NetCube-Systems-Austria/STM32-Ethernet-Board/STMNetBoard.sch

## KiCad design STMNetBoard.sch (2020-12-31)

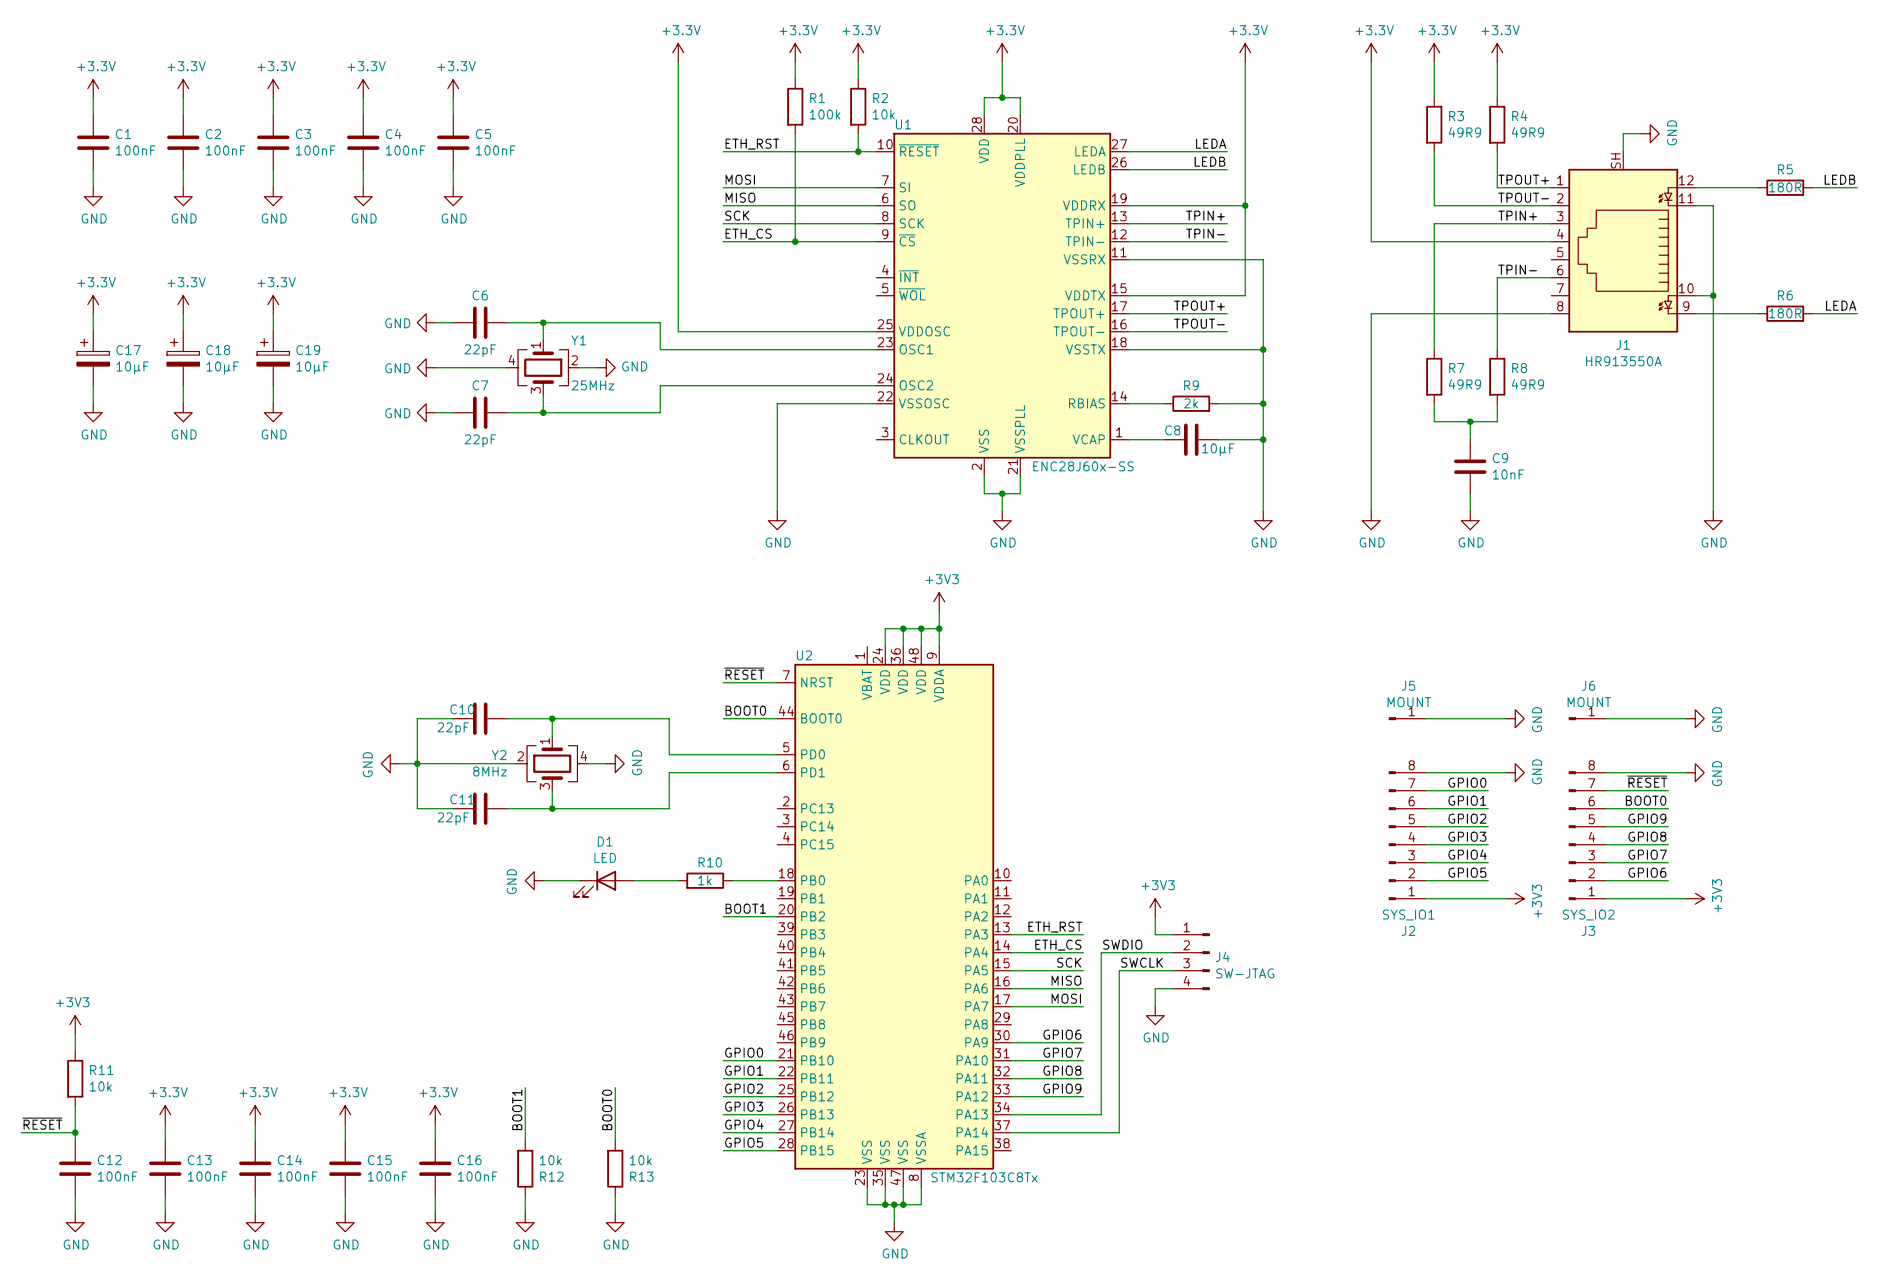
[picture p1: schematic STMNetBoard.sch]

Parts:
C1, C2, C3, C4, C5, C12, C13, C14, C15, C16: 100nF; C_0603_1608Metric; LCSC C14663
C6, C7, C10, C11: 22pF; C_0603_1608Metric; LCSC C1653
C8: 10µF; C_0603_1608Metric; LCSC C19702
C9: 10nF; C_0603_1608Metric; LCSC C57112
C17, C18, C19: 10µF; CP_EIA-3216-18_Kemet-A; LCSC C128254
D1: LED; LED_0603_1608Metric; LCSC C72038
J1: HR913550A; RJ45_Hanrun_HR911105A
J2: SYS_IO1; PinHeader_1x08_P2.54mm_Vertical
J3: SYS_IO2; PinHeader_1x08_P2.54mm_Vertical
J4: SW-JTAG; PinHeader_1x04_P2.54mm_Vertical
J5, J6: MOUNT; PinHeader_1x01_P2.54mm_Vertical
R1: 100k; R_0603_1608Metric; LCSC C25803
R2, R11, R12, R13: 10k; R_0603_1608Metric; LCSC C25804
R3, R4, R7, R8: 49R9; R_0603_1608Metric; LCSC C23185
R5, R6: 180R; R_0603_1608Metric; LCSC C22828
R9: 2k; R_0603_1608Metric; LCSC C22975
R10: 1k; R_0603_1608Metric; LCSC C21190
U1: ENC28J60x-SS; SSOP-28_5.3x10.2mm_P0.65mm; LCSC C8961
U2: STM32F103C8Tx; LQFP-48_7x7mm_P0.5mm; LCSC C8734
Y1: 25MHz; Crystal_SMD_3225-4Pin_3.2x2.5mm; LCSC C164045
Y2: 8MHz; Crystal_SMD_3225-4Pin_3.2x2.5mm; LCSC C117890

Connections:
+3.3V: C1.1, C2.1, C3.1, C4.1, C5.1, C13.1, C14.1, C15.1, C16.1, C17.1, C18.1, C19.1, J1.4, R1.1, R2.1, R3.1, R4.1, U1.15 (VDDTX), U1.19 (VDDRX), U1.20 (VDDPLL), U1.25 (VDDOSC), U1.28 (VDD)
+3V3: J2.1, J3.1, J4.1, R11.1, U2.9 (VDDA), U2.24 (VDD), U2.36 (VDD), U2.48 (VDD)
BOOT0: J3.6, R13.2, U2.44 (BOOT0)
BOOT1: R12.2, U2.20 (PB2)
ETH_CS: R1.2, U1.9 (~CS), U2.14 (PA4)
ETH_RST: R2.2, U1.10 (~RESET), U2.13 (PA3)
GND: C1.2, C2.2, C3.2, C4.2, C5.2, C6.2, C7.2, C8.1, C9.2, C10.2, C11.2, C12.2, C13.2, C14.2, C15.2, C16.2, C17.2, C18.2, C19.2, D1.1 (K), J1.8, J1.10, J1.11, J1.SH, J2.8, J3.8, J4.4, J5.1, J6.1, R9.2, R12.1, R13.1, U1.2 (VSS), U1.11 (VSSRX), U1.18 (VSSTX), U1.21 (VSSPLL), U1.22 (VSSOSC), U2.8 (VSSA), U2.23 (VSS), U2.35 (VSS), U2.47 (VSS), Y1.2, Y1.4, Y2.2, Y2.4
GPIO0: J2.7, U2.21 (PB10)
GPIO1: J2.6, U2.22 (PB11)
GPIO2: J2.5, U2.25 (PB12)
GPIO3: J2.4, U2.26 (PB13)
GPIO4: J2.3, U2.27 (PB14)
GPIO5: J2.2, U2.28 (PB15)
GPIO6: J3.2, U2.30 (PA9)
GPIO7: J3.3, U2.31 (PA10)
GPIO8: J3.4, U2.32 (PA11)
GPIO9: J3.5, U2.33 (PA12)
LEDA: R6.2, U1.27 (LEDA)
LEDB: R5.2, U1.26 (LEDB)
MISO: U1.6 (SO), U2.16 (PA6)
MOSI: U1.7 (SI), U2.17 (PA7)
unnamed: C6.1, U1.23 (OSC1), Y1.1
unnamed: C7.1, U1.24 (OSC2), Y1.3
unnamed: C8.2, U1.1 (VCAP)
unnamed: C9.1, R7.2, R8.2
unnamed: C10.1, U2.5 (PD0), Y2.1
unnamed: C11.1, U2.6 (PD1), Y2.3
unnamed: D1.2 (A), R10.2
unnamed: J1.9, R6.1
unnamed: J1.12, R5.1
unnamed: R9.1, U1.14 (RBIAS)
unnamed: R10.1, U2.18 (PB0)
SCK: U1.8 (SCK), U2.15 (PA5)
SWCLK: J4.3, U2.37 (PA14)
SWDIO: J4.2, U2.34 (PA13)
TPIN+: J1.3, R7.1, U1.13 (TPIN+)
TPIN-: J1.6, R8.1, U1.12 (TPIN-)
TPOUT+: J1.1, R4.2, U1.17 (TPOUT+)
TPOUT-: J1.2, R3.2, U1.16 (TPOUT-)
~RESET: C12.1, J3.7, R11.2, U2.7 (NRST)
